b4ck5p4c3/kicad-library/projects/bksp-pcbmaker-example/bksp-pcbmaker-example.kicad_pcb

## KiCad design projects/bksp-pcbmaker-example/bksp-pcbmaker-example.kicad_pcb (2025-05-07)

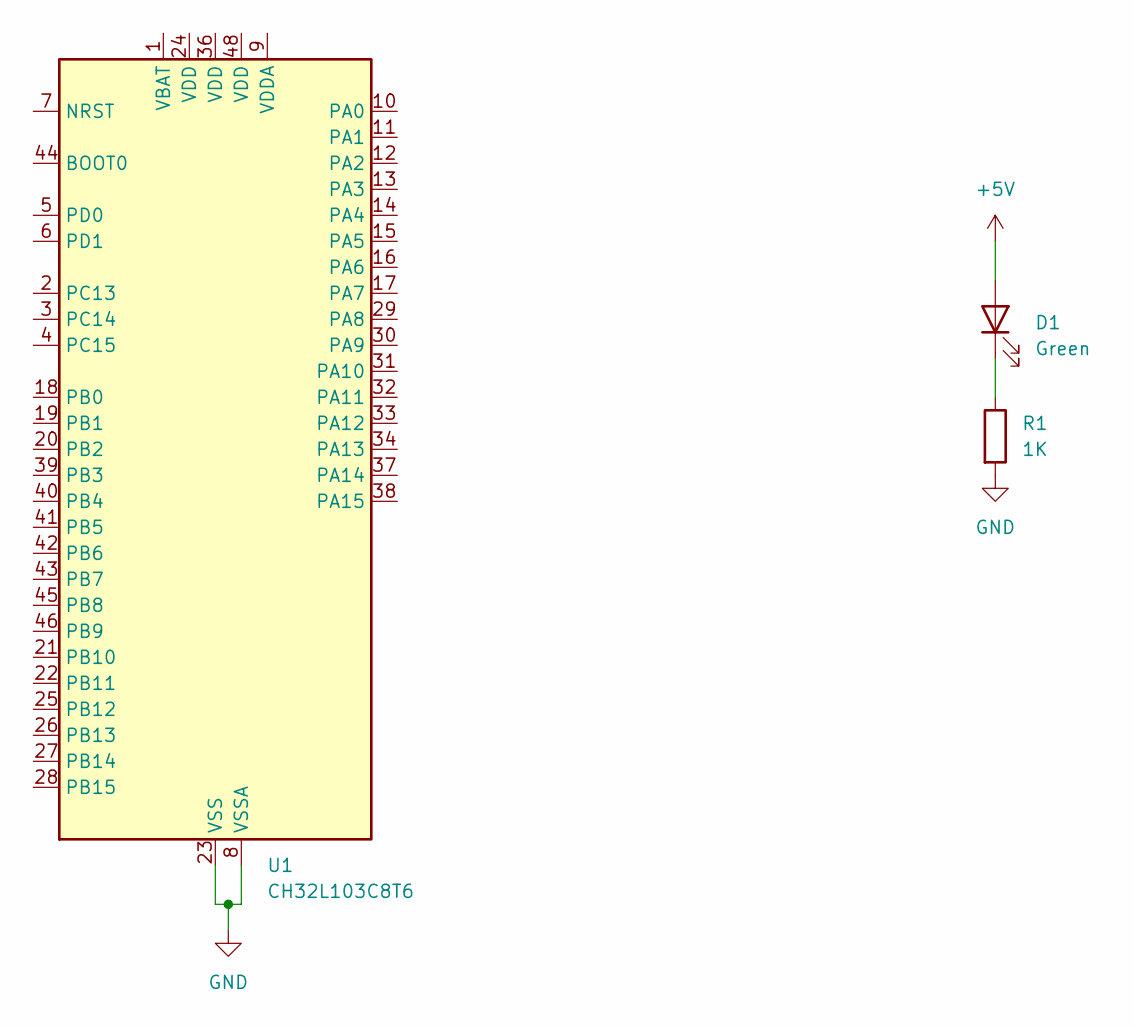
[picture p1: schematic bksp-pcbmaker-example.kicad_sch, Specimen Product (BKSP-XXXX)]

Parts:
D1: Green; LED_1206_3216Metric
R1: 1K; R_0805_2012Metric
U1: CH32L103C8T6; LQFP-48_7x7mm_P0.5mm

Connections:
+5V: D1.2 (A)
GND: R1.2, U1.8 (VSSA), U1.23 (VSS), U1.35 (VSS), U1.47 (VSS)
unnamed: D1.1 (K), R1.1

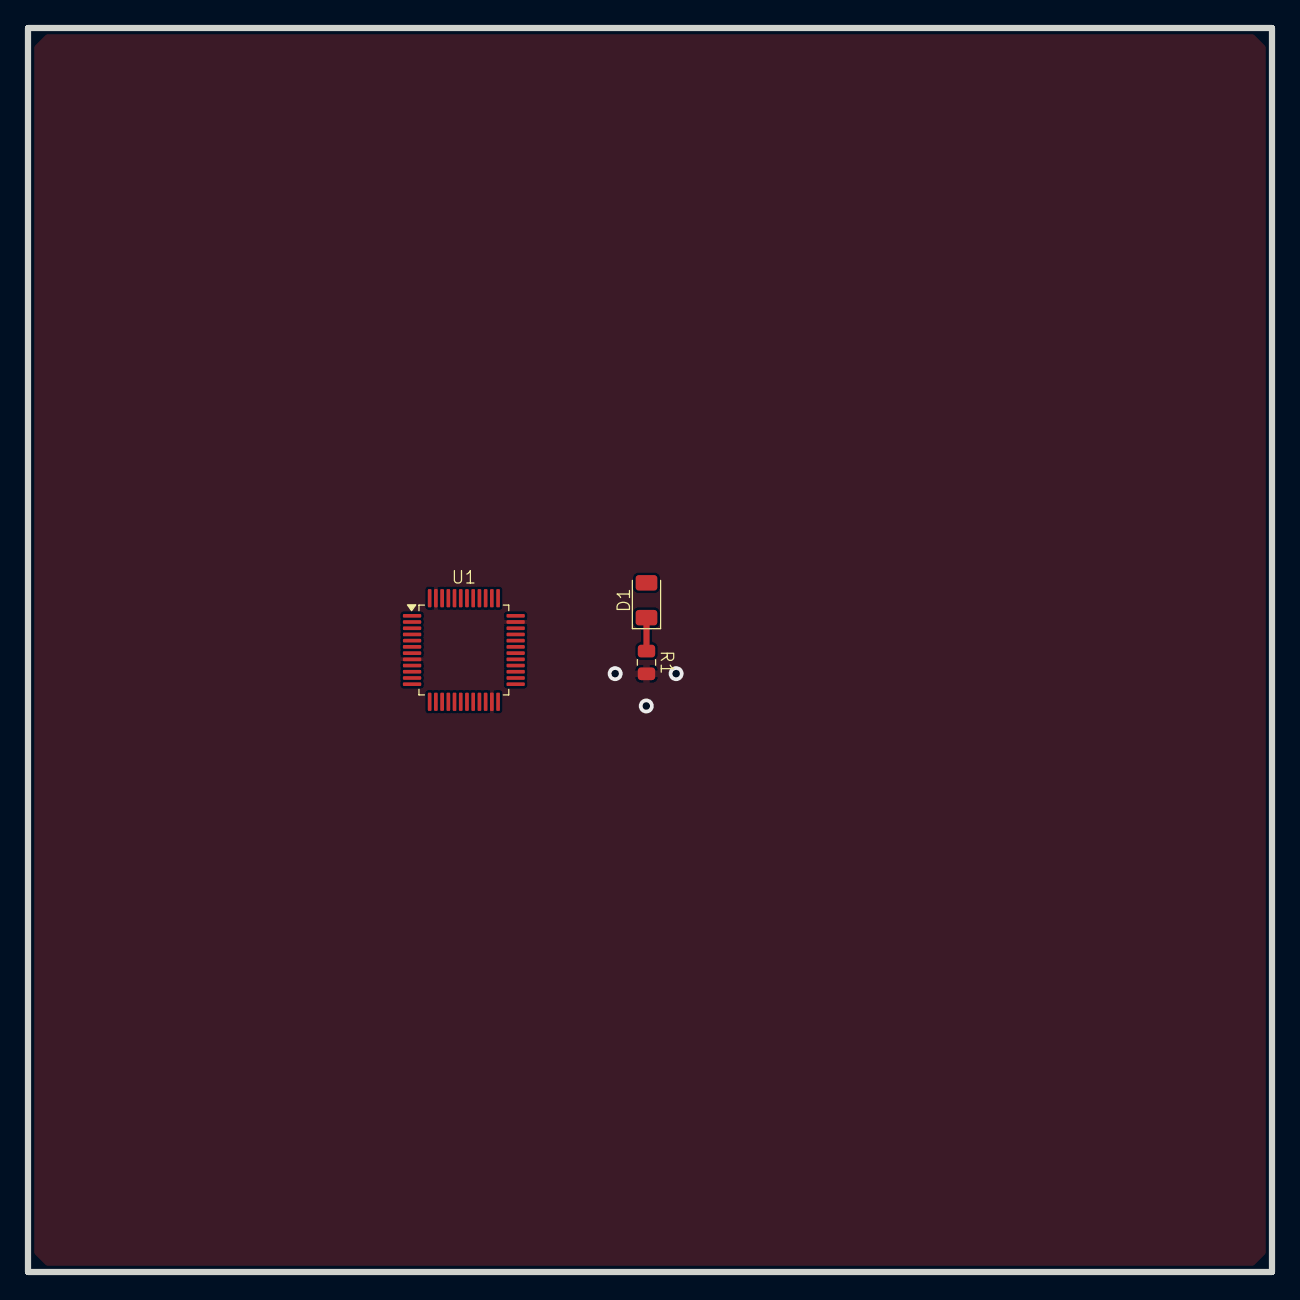
[picture p2: board bksp-pcbmaker-example.kicad_pcb from above]

Board: 2 copper layers, 100.0 x 100.0 mm, 3 parts (0 on the bottom side), 2 nets.
