b4ck5p4c3/kicad-library/(commit log)

2025-04-18 feat: initial
    [bksp-pcbmaker-example.kicad_pcb, bksp-pcbmaker-example.kicad_sch]
2025-05-07 feat(reference): update DRC & Copper Fill settings in a reference project
    [bksp-pcbmaker-example.kicad_pcb, bksp-pcbmaker-example.kicad_sch]
2025-05-07 feat(lib): add footprint for SFP connector without cage
2025-06-19 feat: add CAM-M8Q symbol, footprint, and 3D model
