b4ck5p4c3/kicad-library/(notices)

Notices in the files:
projects/bksp-pcbmaker-example/bksp-pcbmaker-example.kicad_pcb:
CERN-OHL-S
